nbillig/UWYO_Adaptive_Gripper/Images/BannanaJack.jpeg

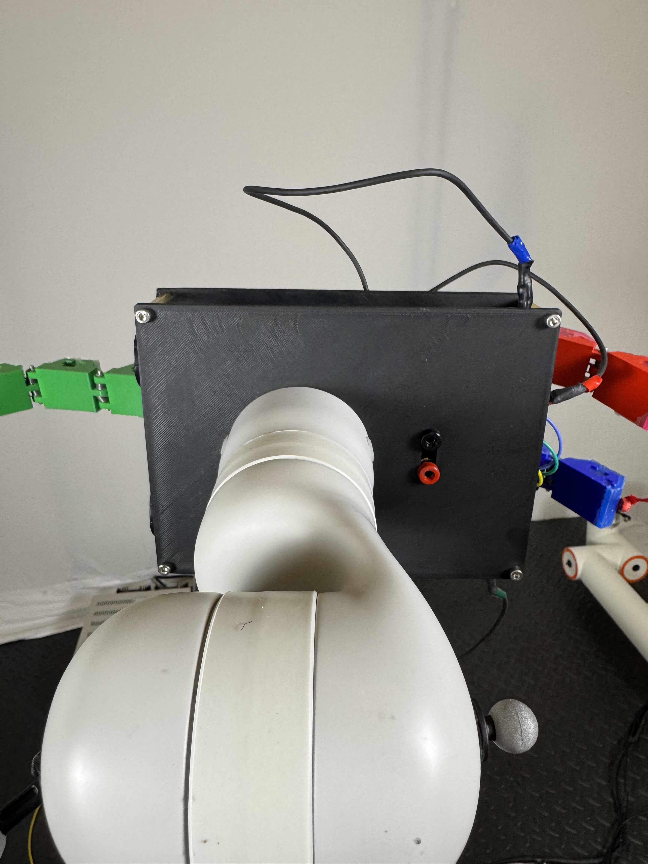
Images/BannanaJack.jpeg
