nbillig/UWYO_Adaptive_Gripper/Images/FFCBreakout.jpeg

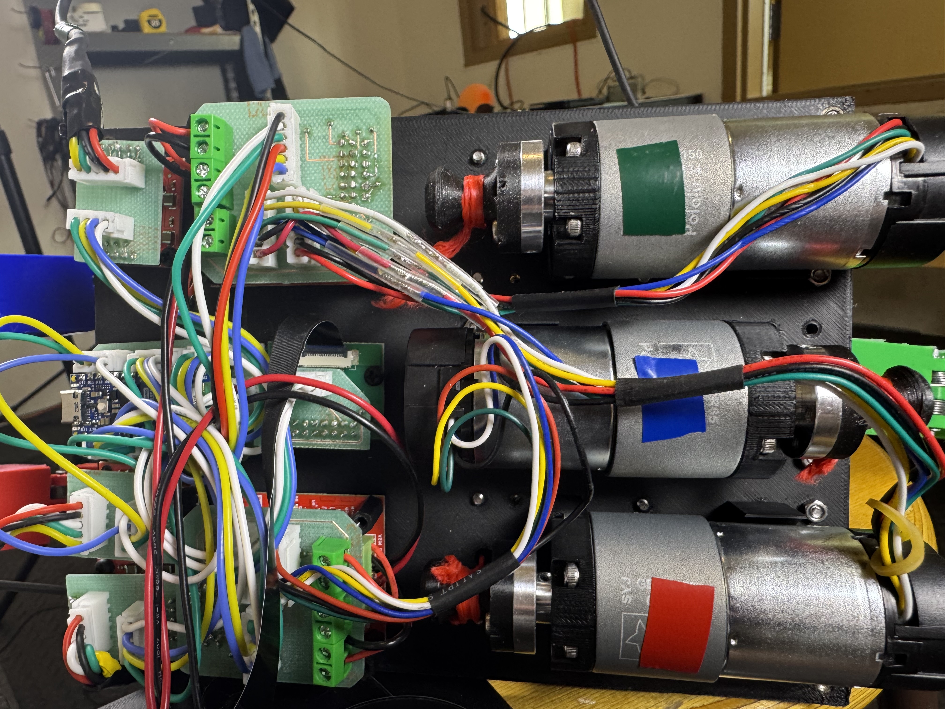
Images/FFCBreakout.jpeg
