nbillig/UWYO_Adaptive_Gripper/Images/PalmPlate.jpeg

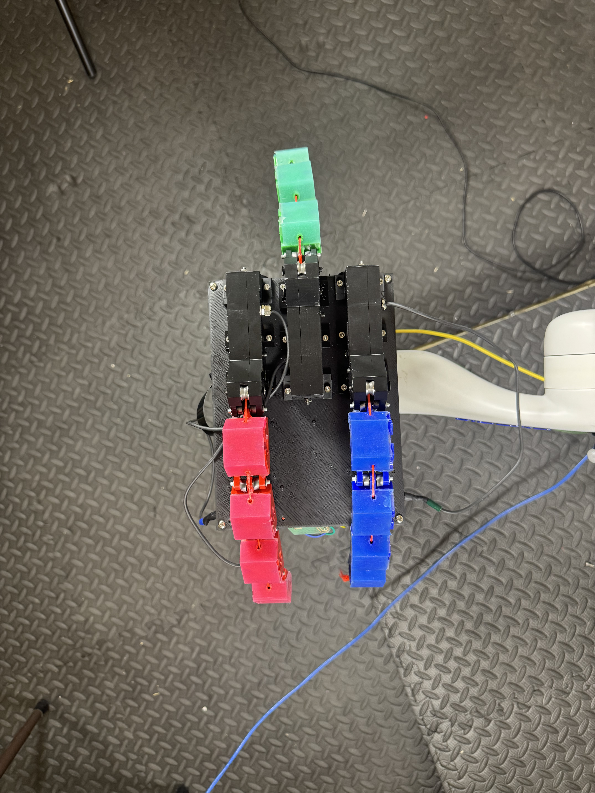
[picture p1: Images/PalmPlate.jpeg]
Images/PalmPlate.jpeg
