nbillig/UWYO_Adaptive_Gripper/Images/OpenView.jpeg

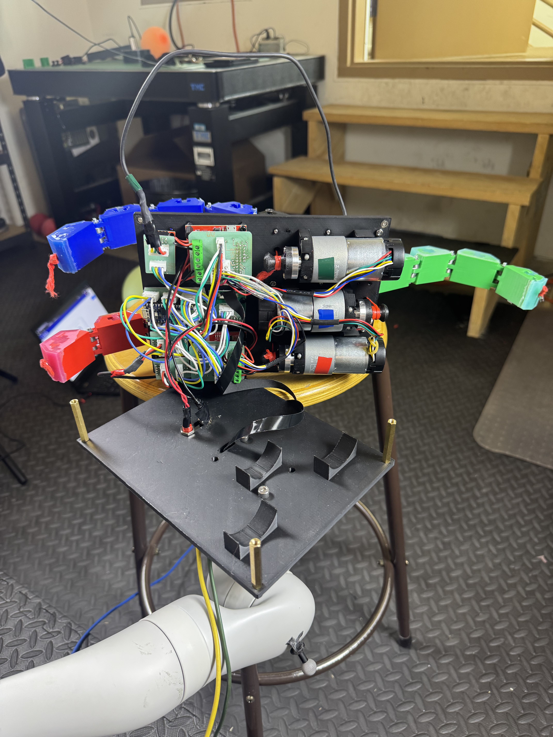
[picture p2: Images/OpenView.jpeg]
Images/OpenView.jpeg
